spherical-sound-society/vortex-generator/Schematics_VortexGen_Rev2.02.pdf

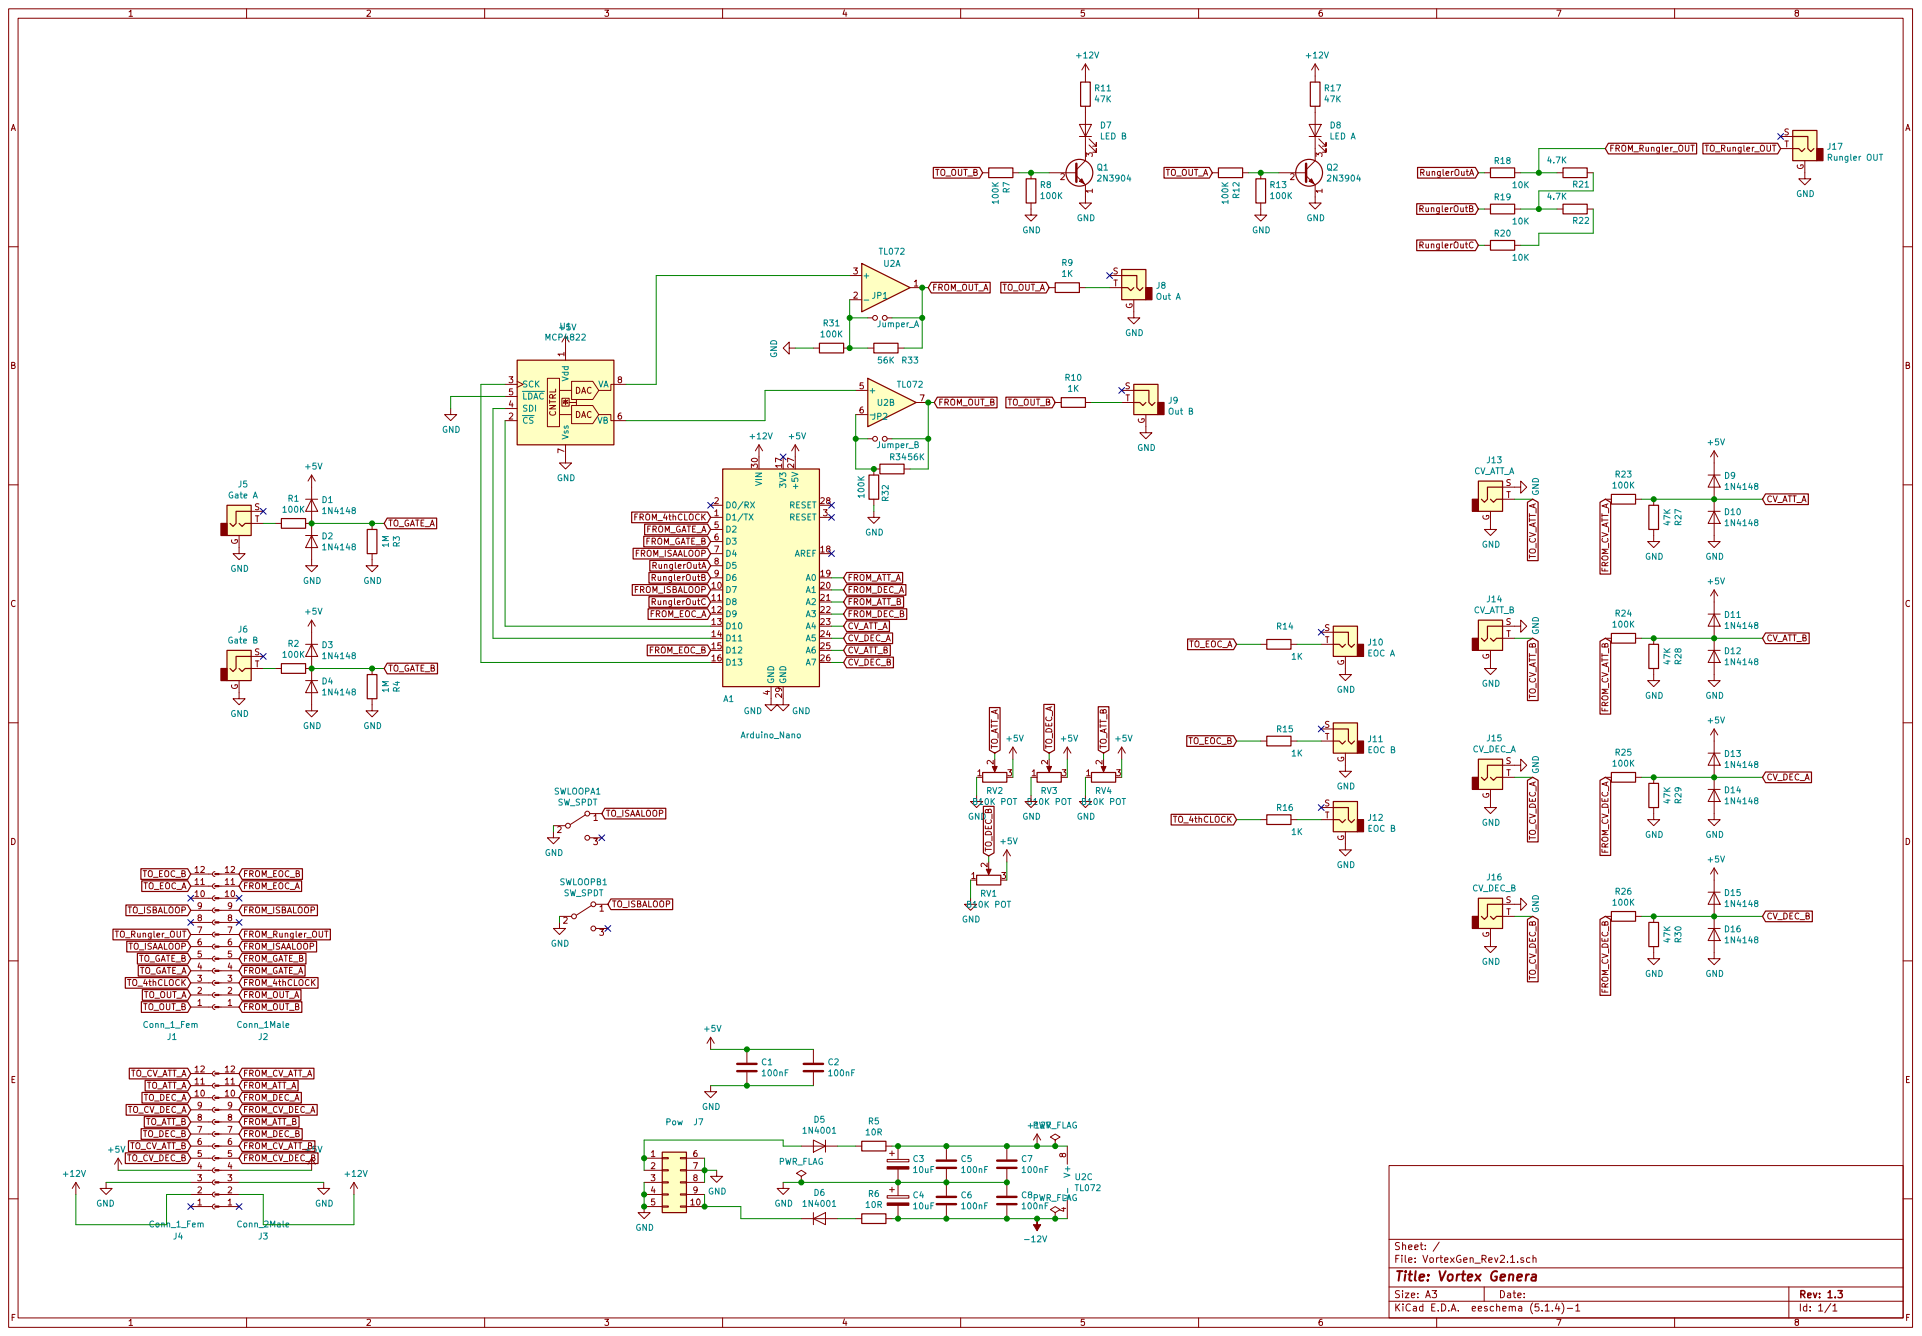
[picture p11: page 1]

Id: 1/1 Title: Vortex Genera
