spherical-sound-society/vortex-generator/(commit log)

2019-12-31 BOM and Build Guide Rev 2
    BOM and Build Guide Rev 2
2019-12-31 BOM in the Build Guide
2019-12-31 BOM and build guide
2020-01-05 Actual shipping PCBs.
    A few resistors changes plus 4 or 8 volts envelope outs selectable by jumpers
2020-01-27 Rev 2.02 schematics
    R33 and R34 appears as 56K in the schematic, but the correct value is 100K as listed in the BOM
2020-02-16 New PCB with bug fixed.
    Version 2.02 need 6 bridges to work. This one just needs 1. Detailed in the document
2020-05-16 Resistor changes making the led less intense
2020-06-06 Current stable version
2020-06-06 Current stable
